iandchasse/silkscreen-audio-attachment/research/basis/README.md

# Basis notes copied from silkscreen-light-attachment (2026-11-09)

These research notes were written for the J6 light attachment. The J6 position, the case facts and the header-mating
analysis carry over unchanged; the electrical notes are about the LED pins and only partly apply. Rev 1.03 changes
(J6 pin 7 behind a 20 mA PTC) are newer than these files: see research/audio-chain.md.
