iandchasse/silkscreen-audio-attachment/pcb/docs/design_summary.md

# As-built design summary (generated by tools/report_design.py; do not edit)

Project silkscreen-audio-attachment rev A, 2026-11-09. Frames: KiCad K (x_K = X + 100, y_K = Z + 100) and enclosure E (X, Z; Y up the device). All SMD parts and the jack are on F.Cu (faces +Y, the top); the THT headers are footprints on B.Cu (bodies under the board).

Board outline bbox (K): x 97.475..162.525, y 93.975..107.025; thickness 1.000 mm; 2 copper layers.

## Parts and sourcing

- J1 Hong Cheng HC-PZ254-11.5L-1x4PZ (LCSC C27985189, JLC Extended (no Basic 2.54 mm headers are listed; checked 2026-11-09); stock 44988 on 2026-11-09), pads J6 1/2/3/4: **hand-soldered by the builder**, in bom.csv, not in jlc_bom.csv / jlc_cpl.csv.
- J2 Hong Cheng HC-PZ254-11.5L-1x1PZ (LCSC C27985186, JLC Extended (no Basic 2.54 mm headers are listed; checked 2026-11-09); stock 5114 on 2026-11-09), pads J6 9: **hand-soldered by the builder**, in bom.csv, not in jlc_bom.csv / jlc_cpl.csv.
- J3 Hong Cheng HC-PZ254-11.5L-1x1PZ (LCSC C27985186, JLC Extended (no Basic 2.54 mm headers are listed; checked 2026-11-09); stock 5114 on 2026-11-09), pads J6 12: **hand-soldered by the builder**, in bom.csv, not in jlc_bom.csv / jlc_cpl.csv.
- Header numbers: body 2.5 / post 6.0 / tail 3.0 / pin 0.64 sq. Source: LCSC/JLC product attributes 2026-11-09 (insulation height 2.5 mm, mating pin 6 mm, end pin 3 mm, square pin, brass, gold, 1x4 = C27985189, 1x1 = C27985186); total 11.5 mm from the MPN; 0.64 mm square pin assumed (not listed).
- Post tips at Y 108.10 (underside 116.60 - body 2.5 - post 6.0); J6 face Y 112.82..113.15 -> engagement 4.72..5.05 mm (limits 3.7..6.0). Tails end at Y 119.60 (2.00 above the PCB top).
- Jack SHOU HAN PJ-313D (LCSC C668608, stock 23114): origin E (2.31, 0.0), nose tip x -5.34, body y 117.6..122.6, barrel axis 2.5 above the board top; pad 1 sleeve GND, 2 ring HP_R, 3 tip HP_L.
- ICs (LCSC stock 2026-11-09): U1 TPS7A2033PDBVR C2862740 (122506), U2 PCM5102APWR C107671 (1284), U3 TPA6138A2PWR C183097 (3332), D1 BAT54SLT1G C8592 (221495).
- CPL rotation offsets (EasyEDA footprints, docs/sources/ee_*.json, tools/cpl_offsets.py): SOT-23-5 +180, TSSOP-20/-14 +270, SOT-23 +180, 0603 +0, jack +0.

## Deviations / notes

- The PJ-313D footprint carries its two Ø1.3 positioning pegs (EasyEDA HOLE records) as NPTH holes at footprint (0, -2.655) and (0, +3.358), i.e. E (-0.345, 0) and (5.668, 0): the board has 4 NPTH holes (2 x Ø4.80 screw columns + 2 x Ø1.30 jack pegs), not 2.

## Footprints

| Ref | Value | Footprint | x_K | y_K | rot | layer | X (E) | Z (E) | pads (num: net) |
|---|---|---|---|---|---|---|---|---|---|
| C1 | CL10A106KP8NNNC | C_0603_1608Metric | 161.200 | 98.500 | 90 | F.Cu | 61.200 | -1.500 | 1: /VBAT, 2: /GND |
| C2 | CL10A105KB8NNNC | C_0603_1608Metric | 155.200 | 102.600 | 0 | F.Cu | 55.200 | 2.600 | 1: /VBAT, 2: /GND |
| C3 | 0603B103K500NT | C_0603_1608Metric | 147.100 | 100.900 | 0 | F.Cu | 47.100 | 0.900 | 1: /PUMP_A, 2: /PUMP |
| C4 | CL10A105KB8NNNC | C_0603_1608Metric | 154.000 | 100.900 | 0 | F.Cu | 54.000 | 0.900 | 1: /EN_DET, 2: /GND |
| C5 | CL10A105KB8NNNC | C_0603_1608Metric | 146.100 | 102.600 | 0 | F.Cu | 46.100 | 2.600 | 1: /MUTE_RC, 2: /GND |
| C6 | CL10A105KB8NNNC | C_0603_1608Metric | 156.100 | 105.600 | 0 | F.Cu | 56.100 | 5.600 | 1: /3V3A, 2: /GND |
| C7 | CC0603KRX7R9BB104 | C_0603_1608Metric | 127.300 | 95.050 | 0 | F.Cu | 27.300 | -4.950 | 1: /3V3A, 2: /GND |
| C8 | CL10A106KP8NNNC | C_0603_1608Metric | 130.400 | 95.050 | 0 | F.Cu | 30.400 | -4.950 | 1: /3V3A, 2: /GND |
| C9 | CL10A225KO8NNNC | C_0603_1608Metric | 125.900 | 98.050 | 90 | F.Cu | 25.900 | -1.950 | 1: /DAC_CAPP, 2: /DAC_CAPM |
| C10 | CL10A225KO8NNNC | C_0603_1608Metric | 123.300 | 98.050 | 90 | F.Cu | 23.300 | -1.950 | 1: /DAC_VNEG, 2: /GND |
| C11 | CC0603KRX7R9BB104 | C_0603_1608Metric | 127.300 | 105.600 | 0 | F.Cu | 27.300 | 5.600 | 1: /3V3A, 2: /GND |
| C12 | CL10A106KP8NNNC | C_0603_1608Metric | 130.400 | 105.600 | 0 | F.Cu | 30.400 | 5.600 | 1: /3V3A, 2: /GND |
| C13 | CC0603KRX7R9BB104 | C_0603_1608Metric | 133.500 | 105.600 | 0 | F.Cu | 33.500 | 5.600 | 1: /DAC_LDOO, 2: /GND |
| C14 | CC0603KRX7R9BB104 | C_0603_1608Metric | 133.500 | 95.050 | 0 | F.Cu | 33.500 | -4.950 | 1: /3V3A, 2: /GND |
| C15 | CL10A106KP8NNNC | C_0603_1608Metric | 153.000 | 105.600 | 0 | F.Cu | 53.000 | 5.600 | 1: /3V3A, 2: /GND |
| C16 | 0603B222K500NT | C_0603_1608Metric | 136.600 | 105.600 | 0 | F.Cu | 36.600 | 5.600 | 1: /DAC_L, 2: /GND |
| C17 | 0603B222K500NT | C_0603_1608Metric | 139.700 | 105.600 | 0 | F.Cu | 39.700 | 5.600 | 1: /DAC_R, 2: /GND |
| C18 | CL10A105KB8NNNC | C_0603_1608Metric | 118.000 | 105.600 | 0 | F.Cu | 18.000 | 5.600 | 1: /3V3A, 2: /GND |
| C19 | CL10A105KB8NNNC | C_0603_1608Metric | 116.000 | 100.000 | 90 | F.Cu | 16.000 | 0.000 | 1: /AMP_CN, 2: /AMP_CP |
| C20 | CL10A105KB8NNNC | C_0603_1608Metric | 114.900 | 95.050 | 0 | F.Cu | 14.900 | -4.950 | 1: /AMP_VSS, 2: /GND |
| C21 | CL10B102KB8NNNC | C_0603_1608Metric | 110.900 | 105.600 | 0 | F.Cu | 10.900 | 5.600 | 1: /HP_L, 2: /GND |
| C22 | CL10B102KB8NNNC | C_0603_1608Metric | 113.900 | 105.600 | 0 | F.Cu | 13.900 | 5.600 | 1: /HP_R, 2: /GND |
| D1 | BAT54SLT1G | SOT-23 | 151.000 | 102.200 | 0 | F.Cu | 51.000 | 2.200 | 1: /GND, 2: /EN_DET, 3: /PUMP |
| H1 | M1 lid screw column (rev C base, left boss moved to x 12) | NPTH_4.80mm | 112.000 | 99.000 | 0 | F.Cu | 12.000 | -1.000 | npth: - |
| H2 | M2 lid screw column | NPTH_4.80mm | 138.000 | 99.000 | 0 | F.Cu | 38.000 | -1.000 | npth: - |
| J1 | HC-PZ254-11.5L-1x4PZ | J6_PLUG_1x4_P1-P4 | 148.312 | 96.190 | 0 | B.Cu | 48.312 | -3.810 | 1: /GND, 2: /I2S_BCLK, 3: /I2S_DOUT, 4: /GND |
| J2 | HC-PZ254-11.5L-1x1PZ | J6_PLUG_1x1_P9 | 149.582 | 98.730 | 0 | B.Cu | 49.582 | -1.270 | 9: /I2S_WS |
| J3 | HC-PZ254-11.5L-1x1PZ | J6_PLUG_1x1_P12 | 157.202 | 98.730 | 0 | B.Cu | 57.202 | -1.270 | 12: /VBAT |
| J4 | PJ-313D | JACK_3.5mm_SHOUHAN_PJ-313D | 102.310 | 100.000 | 90 | F.Cu | 2.310 | 0.000 | npth: -, npth: -, 1: /GND, 1: /GND, 2: /HP_R, 2: /HP_R, 3: /HP_L, 3: /HP_L |
| R1 | 0603WAF1001T5E | R_0603_1608Metric | 144.000 | 100.900 | 0 | F.Cu | 44.000 | 0.900 | 1: /I2S_WS, 2: /PUMP_A |
| R2 | 0603WAF1004T5E | R_0603_1608Metric | 157.100 | 100.700 | 0 | F.Cu | 57.100 | 0.700 | 1: /EN_DET, 2: /GND |
| R3 | 0603WAF1003T5E | R_0603_1608Metric | 143.000 | 102.600 | 0 | F.Cu | 43.000 | 2.600 | 1: /EN_DET, 2: /MUTE_RC |
| R4 | 0603WAF1002T5E | R_0603_1608Metric | 118.000 | 95.050 | 0 | F.Cu | 18.000 | -4.950 | 1: /MUTE_RC, 2: /AMP_MUTE |
| R5 | 0603WAF1003T5E | R_0603_1608Metric | 142.800 | 105.600 | 0 | F.Cu | 42.800 | 5.600 | 1: /I2S_BCLK, 2: /GND |
| R6 | 0603WAF1003T5E | R_0603_1608Metric | 145.900 | 105.600 | 0 | F.Cu | 45.900 | 5.600 | 1: /I2S_DOUT, 2: /GND |
| R7 | 0603WAF1002T5E | R_0603_1608Metric | 149.000 | 105.600 | 0 | F.Cu | 49.000 | 5.600 | 1: /I2S_WS, 2: /GND |
| R8 | 0603WAF4700T5E | R_0603_1608Metric | 125.900 | 101.950 | 90 | F.Cu | 25.900 | 1.950 | 1: /DAC_OUTL, 2: /DAC_L |
| R9 | 0603WAF4700T5E | R_0603_1608Metric | 123.300 | 101.950 | 90 | F.Cu | 23.300 | 1.950 | 1: /DAC_OUTR, 2: /DAC_R |
| R10 | 0603WAF1002T5E | R_0603_1608Metric | 124.200 | 105.600 | 0 | F.Cu | 24.200 | 5.600 | 1: /DAC_L, 2: /AMP_INL |
| R11 | 0603WAF1002T5E | R_0603_1608Metric | 121.100 | 105.600 | 0 | F.Cu | 21.100 | 5.600 | 1: /AMP_INL, 2: /AMP_OUTL |
| R12 | 0603WAF1002T5E | R_0603_1608Metric | 124.200 | 95.050 | 0 | F.Cu | 24.200 | -4.950 | 1: /DAC_R, 2: /AMP_INR |
| R13 | 0603WAF1002T5E | R_0603_1608Metric | 121.100 | 95.050 | 0 | F.Cu | 21.100 | -4.950 | 1: /AMP_INR, 2: /AMP_OUTR |
| R14 | 0603WAF100JT5E | R_0603_1608Metric | 110.900 | 103.100 | 0 | F.Cu | 10.900 | 3.100 | 1: /AMP_OUTL, 2: /HP_L |
| R15 | 0603WAF100JT5E | R_0603_1608Metric | 113.900 | 103.100 | 0 | F.Cu | 13.900 | 3.100 | 1: /AMP_OUTR, 2: /HP_R |
| U1 | TPS7A2033PDBVR | SOT-23-5 | 160.200 | 103.300 | 0 | F.Cu | 60.200 | 3.300 | 1: /VBAT, 2: /GND, 3: /EN_DET, 4: unconnected-(U1-NC-Pad4), 5: /3V3A |
| U2 | PCM5102APWR | TSSOP-20_4.4x6.5mm_P0.65mm | 130.900 | 100.000 | 0 | F.Cu | 30.900 | 0.000 | 1: /3V3A, 2: /DAC_CAPP, 3: /GND, 4: /DAC_CAPM, 5: /DAC_VNEG, 6: /DAC_OUTL, 7: /DAC_OUTR, 8: /3V3A, 9: /GND, 10: /GND, 11: /GND, 12: /GND, 13: /I2S_BCLK, 14: /I2S_DOUT, 15: /I2S_WS, 16: /GND, 17: /3V3A, 18: /DAC_LDOO, 19: /GND, 20: /3V3A |
| U3 | TPA6138A2PWR | TSSOP-14_4.4x5mm_P0.65mm | 119.500 | 100.000 | -90 | F.Cu | 19.500 | 0.000 | 1: /GND, 2: /AMP_INR, 3: /AMP_OUTR, 4: /GND, 5: /AMP_MUTE, 6: /AMP_VSS, 7: /AMP_CN, 8: /AMP_CP, 9: /3V3A, 10: /GND, 11: unconnected-(U3-UVP-Pad11), 12: /AMP_OUTL, 13: /AMP_INL, 14: /GND |

## Copper by net

| Net | F.Cu mm | B.Cu mm | vias |
|---|---|---|---|
| /3V3A | 64.2 | 6.8 | 2 |
| /AMP_CN | 0.7 | 3.1 | 2 |
| /AMP_CP | 1.3 | 1.7 | 2 |
| /AMP_INL | 3.3 | 3.3 | 2 |
| /AMP_INR | 2.5 | 3.3 | 2 |
| /AMP_MUTE | 1.6 | 0.0 | 0 |
| /AMP_OUTL | 6.5 | 9.5 | 2 |
| /AMP_OUTR | 16.4 | 0.0 | 0 |
| /AMP_VSS | 5.5 | 0.0 | 0 |
| /DAC_CAPM | 1.7 | 0.0 | 0 |
| /DAC_CAPP | 4.8 | 0.0 | 0 |
| /DAC_L | 15.9 | 0.0 | 0 |
| /DAC_LDOO | 7.3 | 0.0 | 0 |
| /DAC_OUTL | 3.9 | 3.6 | 2 |
| /DAC_OUTR | 2.2 | 2.0 | 2 |
| /DAC_R | 8.1 | 13.6 | 2 |
| /DAC_VNEG | 1.8 | 3.5 | 2 |
| /EN_DET | 19.4 | 5.3 | 2 |
| /GND | 11.6 | 0.0 | 95 |
| /HP_L | 10.8 | 0.0 | 0 |
| /HP_R | 17.3 | 0.0 | 0 |
| /I2S_BCLK | 7.7 | 10.7 | 2 |
| /I2S_DOUT | 2.3 | 21.2 | 2 |
| /I2S_WS | 27.3 | 0.0 | 0 |
| /MUTE_RC | 1.1 | 40.4 | 3 |
| /PUMP | 2.5 | 1.2 | 2 |
| /PUMP_A | 0.7 | 0.0 | 0 |
| /VBAT | 10.1 | 0.0 | 0 |

## Handedness / placement gate (tools/check_handedness.py)

- PASS STEP->E rotation determinant 1 (proper rotation, not a mirror)
- PASS F.Cu face seen from +Y: right = +X, down = (0, 0, 1) = +Z, so x_K = X + 100, y_K = Z + 100 is unmirrored
- PASS exactly 6 plated through-holes, all on J1/J2/J3 (found 6)
- PASS J3 '12' at E (57.202, -1.270) vs J6-12 (57.202, -1.270): 0.0000 <= 0.02
- PASS J3 '12' via the STEP chain: E (57.202, Y 116.60, -1.270) agrees
- PASS J3 '12' net VBAT == VBAT
- PASS J2 '9' at E (49.582, -1.270) vs J6-9 (49.582, -1.270): 0.0000 <= 0.02
- PASS J2 '9' via the STEP chain: E (49.582, Y 116.60, -1.270) agrees
- PASS J2 '9' net I2S_WS == I2S_WS
- PASS J1 '1' at E (44.502, -3.810) vs J6-1 (44.502, -3.810): 0.0000 <= 0.02
- PASS J1 '1' via the STEP chain: E (44.502, Y 116.60, -3.810) agrees
- PASS J1 '1' net GND == GND
- PASS J1 '2' at E (47.042, -3.810) vs J6-2 (47.042, -3.810): 0.0000 <= 0.02
- PASS J1 '2' via the STEP chain: E (47.042, Y 116.60, -3.810) agrees
- PASS J1 '2' net I2S_BCLK == I2S_BCLK
- PASS J1 '3' at E (49.582, -3.810) vs J6-3 (49.582, -3.810): 0.0000 <= 0.02
- PASS J1 '3' via the STEP chain: E (49.582, Y 116.60, -3.810) agrees
- PASS J1 '3' net I2S_DOUT == I2S_DOUT
- PASS J1 '4' at E (52.122, -3.810) vs J6-4 (52.122, -3.810): 0.0000 <= 0.02
- PASS J1 '4' via the STEP chain: E (52.122, Y 116.60, -3.810) agrees
- PASS J1 '4' net GND == GND
- PASS J1 footprint on B.Cu (body under the board)
- PASS J2 footprint on B.Cu (body under the board)
- PASS J3 footprint on B.Cu (body under the board)
- PASS J4 on F.Cu (top side)
- PASS J4 origin at E (2.310, 0.000)
- PASS J4 nose tip at x -5.340 (spec -5.34), rotation 90 (nose toward -X)
- PASS J4 has 6 SMD pads (found 6)
- PASS J4 pad 1 at E (-1.045, 3.600) (want x -1.045, z +-3.60)
- PASS J4 pad 1 net GND == GND
- PASS J4 pad 1 at E (-1.045, -3.600) (want x -1.045, z +-3.60)
- PASS J4 pad 1 net GND == GND
- PASS J4 pad 2 at E (2.165, 3.600) (want x 2.165, z +-3.60)
- PASS J4 pad 2 net HP_R == HP_R
- PASS J4 pad 2 at E (2.165, -3.600) (want x 2.165, z +-3.60)
- PASS J4 pad 2 net HP_R == HP_R
- PASS J4 pad 3 at E (5.666, 3.600) (want x 5.666, z +-3.60)
- PASS J4 pad 3 net HP_L == HP_L
- PASS J4 pad 3 at E (5.666, -3.600) (want x 5.666, z +-3.60)
- PASS J4 pad 3 net HP_L == HP_L
- PASS J6-5 (LED_SW up to 25.5 V) at E (54.662, -3.81): nearest pad 1.690, via 1.034, hole 1.184 (>= 1.0)
- PASS J6-6 (W-) at E (57.202, -3.81): nearest pad 1.690, via 1.217, hole 1.367 (>= 1.0)
- PASS J6-7 (J6_3V3) at E (44.502, -1.27): nearest pad 1.690, via 1.488, hole 1.638 (>= 1.0)
- PASS J6-8 (SDA) at E (47.042, -1.27): nearest pad 1.690, via 2.190, hole 2.030 (>= 1.0)
- PASS J6-10 (SCL) at E (52.122, -1.27): nearest pad 1.690, via 1.036, hole 1.186 (>= 1.0)
- PASS J6-11 (C-) at E (54.662, -1.27): nearest pad 1.690, via 1.105, hole 1.255 (>= 1.0)
- PASS 4 NPTH holes (params: 4 = 2 screw columns + 2 jack pegs)
- PASS NPTH M1 dia 4.8 at E (12.000, -1.000)
- PASS NPTH M2 dia 4.8 at E (38.000, -1.000)
- PASS NPTH peg dia 1.3 at E (-0.345, 0.000)
- PASS NPTH peg dia 1.3 at E (5.668, 0.000)
- PASS copper (pads/tracks/vias) to the screw-column hole edges min 0.549 >= 0.4
- PASS tracks to the screw-column hole edges min 0.549 >= 0.5
- PASS R12 on F.Cu
- PASS R12 pads E x 22.97..25.42 z -5.42..-4.47, h 0.55: inside the region, clear of the columns and header pads
- PASS C4 on F.Cu
- PASS C4 pads E x 52.78..55.22 z 0.42..1.38, h 0.95: inside the region, clear of the columns and header pads
- PASS C10 on F.Cu
- PASS C10 pads E x 22.83..23.78 z -3.17..-0.72, h 0.95: inside the region, clear of the columns and header pads
- PASS C9 on F.Cu
- PASS C9 pads E x 25.42..26.38 z -3.17..-0.72, h 0.95: inside the region, clear of the columns and header pads
- PASS C20 on F.Cu
- PASS C20 pads E x 13.67..16.12 z -5.42..-4.47, h 0.95: inside the region, clear of the columns and header pads
- PASS C16 on F.Cu
- PASS C16 pads E x 35.38..37.82 z 5.12..6.08, h 0.95: inside the region, clear of the columns and header pads
- PASS U3 on F.Cu
- PASS U3 pads E x 17.35..21.65 z -3.60..3.60, h 1.2: inside the region, clear of the columns and header pads
- PASS R10 on F.Cu
- PASS R10 pads E x 22.97..25.42 z 5.12..6.08, h 0.55: inside the region, clear of the columns and header pads
- PASS R7 on F.Cu
- PASS R7 pads E x 47.78..50.22 z 5.12..6.08, h 0.55: inside the region, clear of the columns and header pads
- PASS R4 on F.Cu
- PASS R4 pads E x 16.78..19.22 z -5.42..-4.47, h 0.55: inside the region, clear of the columns and header pads
- PASS R9 on F.Cu
- PASS R9 pads E x 22.83..23.78 z 0.72..3.17, h 0.55: inside the region, clear of the columns and header pads
- PASS C8 on F.Cu
- PASS C8 pads E x 29.18..31.62 z -5.42..-4.47, h 0.95: inside the region, clear of the columns and header pads
- PASS C13 on F.Cu
- PASS C13 pads E x 32.28..34.72 z 5.12..6.08, h 0.95: inside the region, clear of the columns and header pads
- PASS R11 on F.Cu
- PASS R11 pads E x 19.88..22.33 z 5.12..6.08, h 0.55: inside the region, clear of the columns and header pads
- PASS C18 on F.Cu
- PASS C18 pads E x 16.78..19.22 z 5.12..6.08, h 0.95: inside the region, clear of the columns and header pads
- PASS C14 on F.Cu
- PASS C14 pads E x 32.28..34.72 z -5.42..-4.47, h 0.95: inside the region, clear of the columns and header pads
- PASS C11 on F.Cu
- PASS C11 pads E x 26.08..28.53 z 5.12..6.08, h 0.95: inside the region, clear of the columns and header pads
- PASS C3 on F.Cu
- PASS C3 pads E x 45.88..48.32 z 0.42..1.38, h 0.95: inside the region, clear of the columns and header pads
- PASS D1 on F.Cu
- PASS D1 pads E x 49.32..52.68 z 0.95..3.45, h 1.15: inside the region, clear of the columns and header pads
- PASS C7 on F.Cu
- PASS C7 pads E x 26.08..28.53 z -5.42..-4.47, h 0.95: inside the region, clear of the columns and header pads
- PASS R14 on F.Cu
- PASS R14 pads E x 9.67..12.12 z 2.62..3.58, h 0.55: inside the region, clear of the columns and header pads
- PASS R5 on F.Cu
- PASS R5 pads E x 41.57..44.03 z 5.12..6.08, h 0.55: inside the region, clear of the columns and header pads
- PASS C12 on F.Cu
- PASS C12 pads E x 29.18..31.62 z 5.12..6.08, h 0.95: inside the region, clear of the columns and header pads
- PASS J4 on F.Cu
- PASS R8 on F.Cu
- PASS R8 pads E x 25.42..26.38 z 0.72..3.17, h 0.55: inside the region, clear of the columns and header pads
- PASS C17 on F.Cu
- PASS C17 pads E x 38.47..40.93 z 5.12..6.08, h 0.95: inside the region, clear of the columns and header pads
- PASS R6 on F.Cu
- PASS R6 pads E x 44.68..47.12 z 5.12..6.08, h 0.55: inside the region, clear of the columns and header pads
- PASS R3 on F.Cu
- PASS R3 pads E x 41.78..44.22 z 2.12..3.08, h 0.55: inside the region, clear of the columns and header pads
- PASS R13 on F.Cu
- PASS R13 pads E x 19.88..22.33 z -5.42..-4.47, h 0.55: inside the region, clear of the columns and header pads
- PASS C19 on F.Cu
- PASS C19 pads E x 15.53..16.47 z -1.22..1.22, h 0.95: inside the region, clear of the columns and header pads
- PASS C15 on F.Cu
- PASS C15 pads E x 51.78..54.22 z 5.12..6.08, h 0.95: inside the region, clear of the columns and header pads
- PASS C6 on F.Cu
- PASS C6 pads E x 54.88..57.32 z 5.12..6.08, h 0.95: inside the region, clear of the columns and header pads
- PASS C21 on F.Cu
- PASS C21 pads E x 9.67..12.12 z 5.12..6.08, h 0.95: inside the region, clear of the columns and header pads
- PASS R1 on F.Cu
- PASS R1 pads E x 42.78..45.22 z 0.42..1.38, h 0.55: inside the region, clear of the columns and header pads
- PASS U2 on F.Cu
- PASS U2 pads E x 27.30..34.50 z -3.12..3.12, h 1.2: inside the region, clear of the columns and header pads
- PASS U1 on F.Cu
- PASS U1 pads E x 58.40..62.00 z 2.05..4.55, h 1.25: inside the region, clear of the columns and header pads
- PASS C1 on F.Cu
- PASS C1 pads E x 60.72..61.68 z -2.72..-0.28, h 0.95: inside the region, clear of the columns and header pads
- PASS R2 on F.Cu
- PASS R2 pads E x 55.88..58.32 z 0.22..1.17, h 0.55: inside the region, clear of the columns and header pads
- PASS C2 on F.Cu
- PASS C2 pads E x 53.97..56.43 z 2.12..3.08, h 0.95: inside the region, clear of the columns and header pads
- PASS R15 on F.Cu
- PASS R15 pads E x 12.67..15.12 z 2.62..3.58, h 0.55: inside the region, clear of the columns and header pads
- PASS C22 on F.Cu
- PASS C22 pads E x 12.67..15.12 z 5.12..6.08, h 0.95: inside the region, clear of the columns and header pads
- PASS C5 on F.Cu
- PASS C5 pads E x 44.88..47.32 z 2.12..3.08, h 0.95: inside the region, clear of the columns and header pads
- PASS NPTH J4@E(-0.34,0.00): web to board edge 1.505 >= 0.5
- PASS NPTH H1@E(12.00,-1.00): web to board edge 2.600 >= 0.5
- PASS NPTH H2@E(38.00,-1.00): web to board edge 2.600 >= 0.5
- PASS NPTH J4@E(5.67,0.00): web to board edge 5.350 >= 0.5
- INFO outline 8 Edge.Cuts primitives; min NPTH web 1.505
- PASS silk: 103 strokes, min width 0.150 >= 0.15
- PASS silk: 10 visible texts, min height 1.000, min stroke 0.150
