iandchasse/silkscreen-audio-attachment/housing/out/render/exploded_iso.png

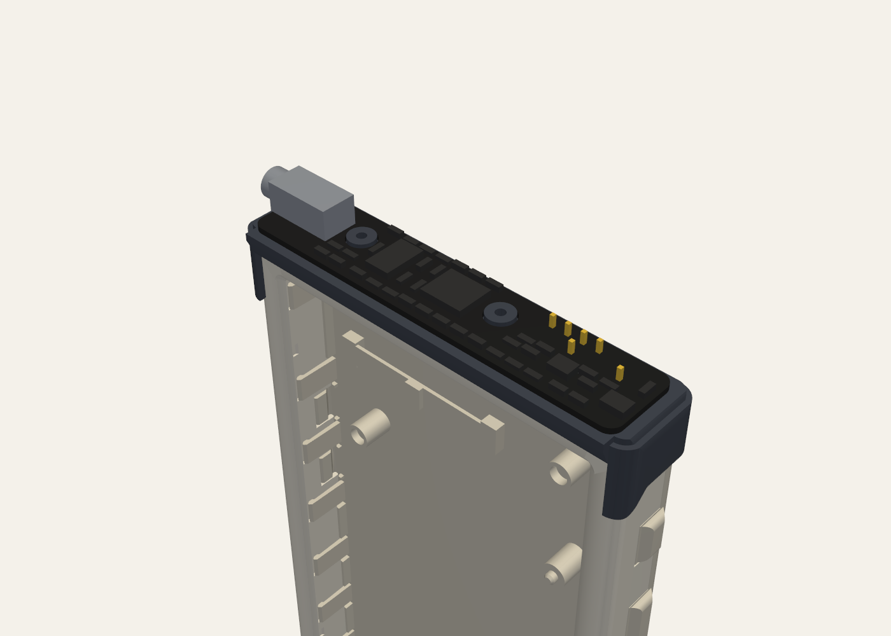
housing/out/render/exploded_iso.png
