iandchasse/silkscreen-audio-attachment/housing/out/render/front.png

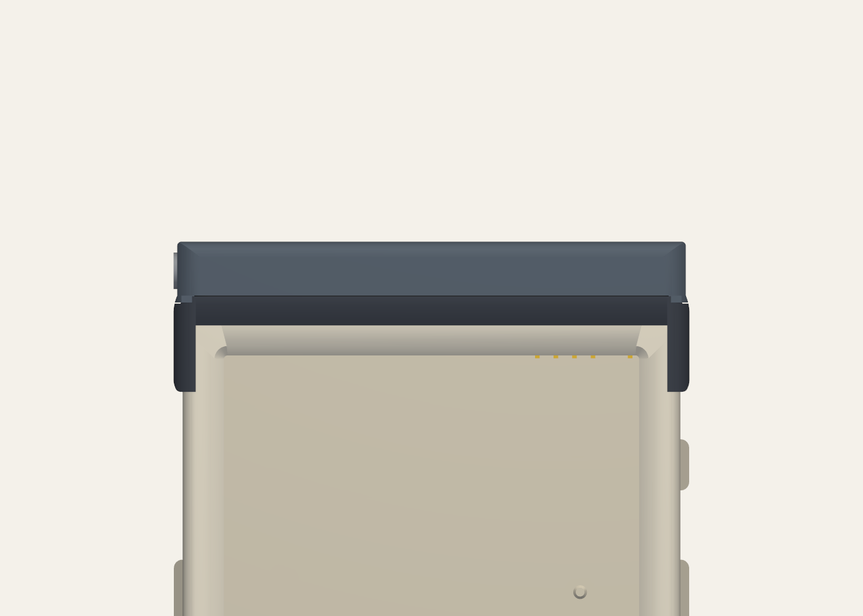
housing/out/render/front.png
