iandchasse/silkscreen-audio-attachment/housing/out/render/left_end_iso.png

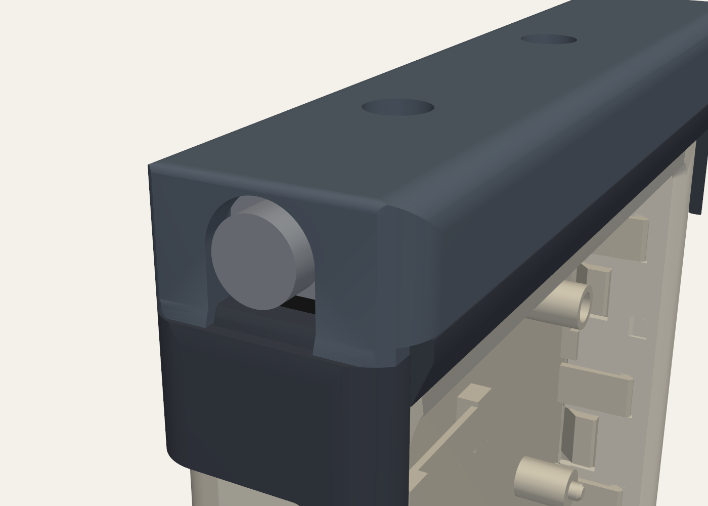
housing/out/render/left_end_iso.png
