iandchasse/silkscreen-audio-attachment/housing/out/render/left_end_jack_opening.png

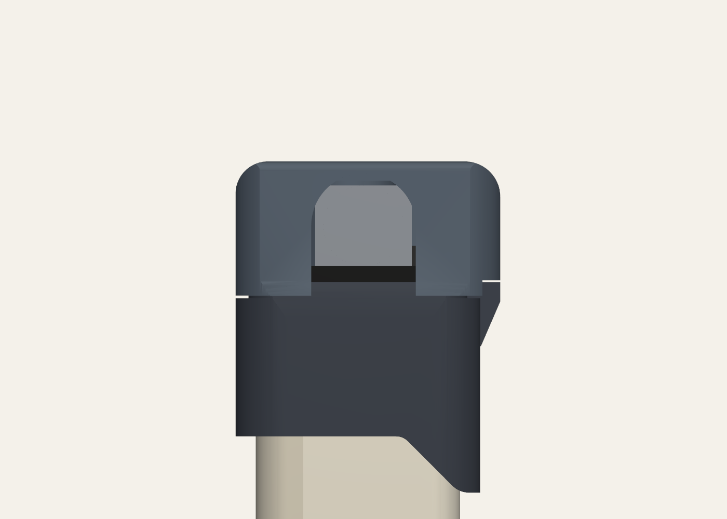
housing/out/render/left_end_jack_opening.png
