iandchasse/silkscreen-audio-attachment/housing/out/render/section_boss_x12.png

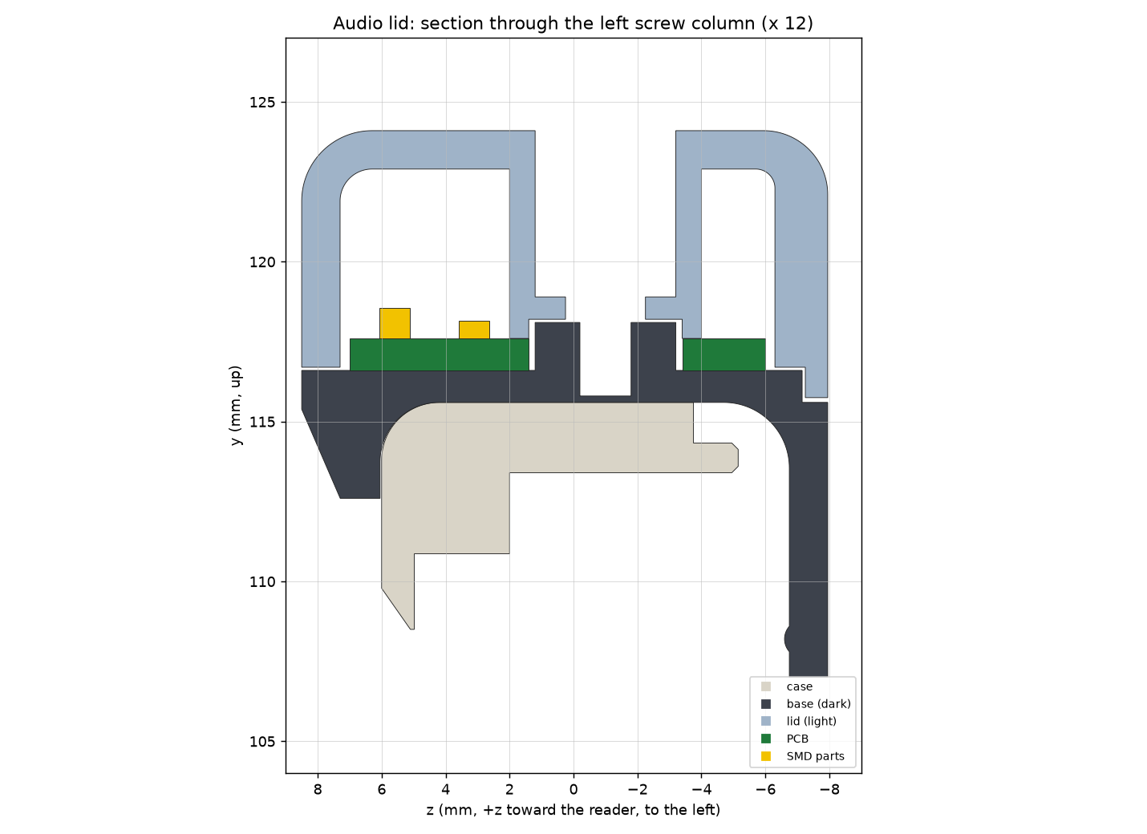
housing/out/render/section_boss_x12.png
