iandchasse/silkscreen-audio-attachment/housing/out/render/section_jack_axis_z0.png

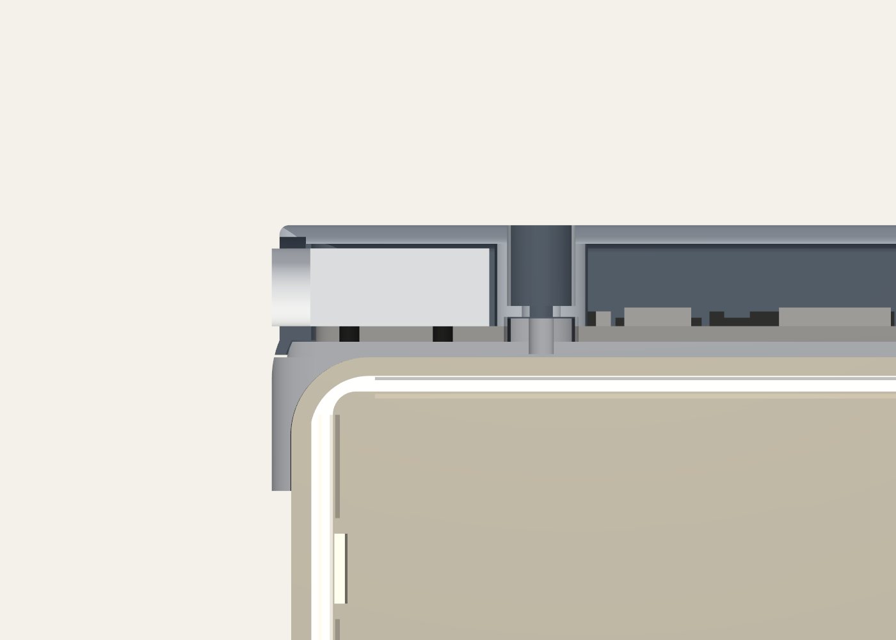
housing/out/render/section_jack_axis_z0.png
