iandchasse/silkscreen-audio-attachment/housing/out/render/section_jack_x2.3.png

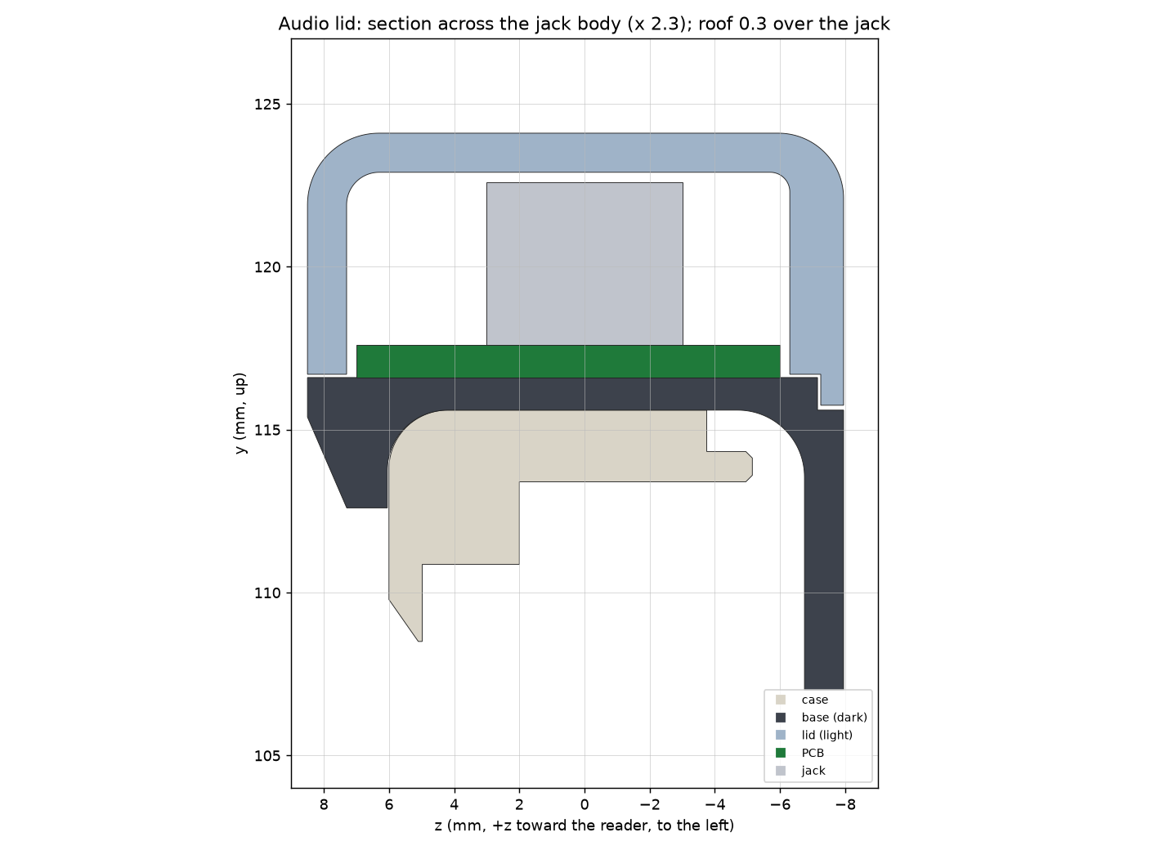
housing/out/render/section_jack_x2.3.png
