iandchasse/silkscreen-audio-attachment/housing/out/render/section_plug_opening_x-4.png

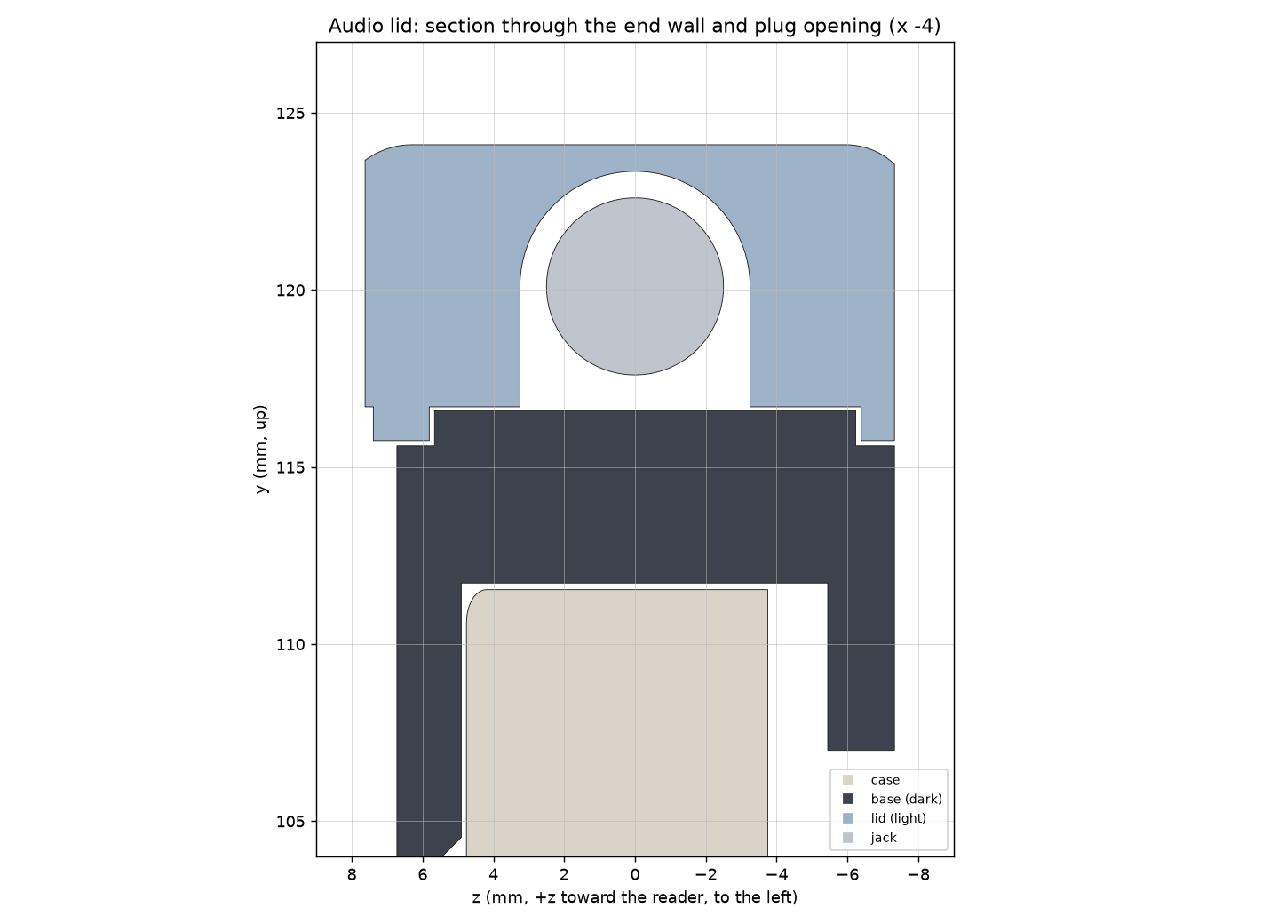
housing/out/render/section_plug_opening_x-4.png
