iandchasse/silkscreen-audio-attachment/pcb/docs/images/render_bottom.png

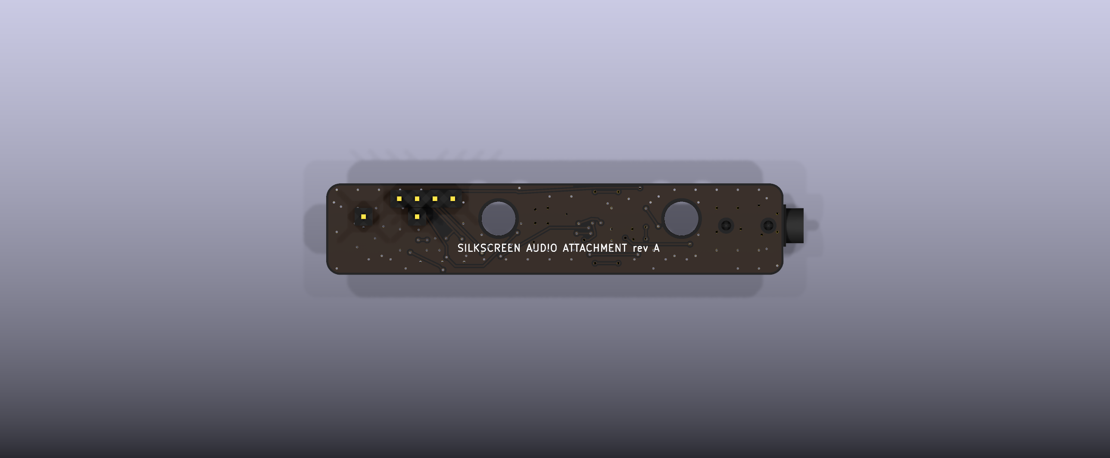
pcb/docs/images/render_bottom.png
