iandchasse/silkscreen-audio-attachment/pcb/production/bom.csv

Qty | Refs | Value | Manufacturer | MPN | DigiKey | LCSC | JLC type | Footprint | Assembly | Description
4 | C1,C8,C12,C15 | CL10A106KP8NNNC | Samsung Electro-Mechanics | CL10A106KP8NNNC | search DigiKey for CL10A106KP8NNNC (part number not verified) | C19702 | JLC Basic | C_0603_1608Metric | JLC SMT (top side) | 10 uF 10 V X5R 0603
7 | C2,C4,C5,C6,C18,C19,C20 | CL10A105KB8NNNC | Samsung Electro-Mechanics | CL10A105KB8NNNC | search DigiKey for CL10A105KB8NNNC (part number not verified) | C15849 | JLC Basic | C_0603_1608Metric | JLC SMT (top side) | 1 uF 50 V X5R 0603
1 | C3 | 0603B103K500NT | Fenghua (FH) | 0603B103K500NT | search DigiKey for 0603B103K500NT (part number not verified) | C57112 | JLC Basic | C_0603_1608Metric | JLC SMT (top side) | 10 nF 50 V X7R 0603
4 | C7,C11,C13,C14 | CC0603KRX7R9BB104 | Yageo | CC0603KRX7R9BB104 | search DigiKey for CC0603KRX7R9BB104 (part number not verified) | C14663 | JLC Basic | C_0603_1608Metric | JLC SMT (top side) | 100 nF 50 V X7R 0603
2 | C9,C10 | CL10A225KO8NNNC | Samsung Electro-Mechanics | CL10A225KO8NNNC | search DigiKey for CL10A225KO8NNNC (part number not verified) | C23630 | JLC Basic | C_0603_1608Metric | JLC SMT (top side) | 2.2 uF 16 V X5R 0603
2 | C16,C17 | 0603B222K500NT | Fenghua (FH) | 0603B222K500NT | search DigiKey for 0603B222K500NT (part number not verified) | C1604 | JLC Basic | C_0603_1608Metric | JLC SMT (top side) | 2.2 nF 50 V X7R 0603
2 | C21,C22 | CL10B102KB8NNNC | Samsung Electro-Mechanics | CL10B102KB8NNNC | search DigiKey for CL10B102KB8NNNC (part number not verified) | C1588 | JLC Basic | C_0603_1608Metric | JLC SMT (top side) | 1 nF 50 V X7R 0603
1 | D1 | BAT54SLT1G | onsemi | BAT54SLT1G | BAT54SLT1GOSCT-ND | C8592 | JLC Extended | SOT-23 | JLC SMT (top side) | Dual Schottky diode, series pair, SOT-23. JLC/LCSC part: Jiangsu Changjing BAT54S (C8592)
1 | J1 | HC-PZ254-11.5L-1x4PZ | Hong Cheng | HC-PZ254-11.5L-1x4PZ | n/a - Hong Cheng is LCSC-only; DigiKey equivalent: Harwin M20-999 series 1x4 cut from a longer strip (6.1 mm post, 3 mm tail), part number not verified | C27985189 | JLC Extended | J6_PLUG_1x4_P1-P4 | THT: JLC hand-solders it, or untick it at JLC and solder it yourself | 1x4 2.54 mm straight male pin header, body 2.5, mating post 6.0, tail 3.0, 0.64 sq; mounted from the underside, soldered by the builder on the top side; pins = J6 1/2/3/4
1 | J2 | HC-PZ254-11.5L-1x1PZ | Hong Cheng | HC-PZ254-11.5L-1x1PZ | 1 pin cut from a Harwin M20-999 series strip (6.1 mm post, 3 mm tail), part number not verified | C27985186 | JLC Extended | J6_PLUG_1x1_P9 | THT: JLC hand-solders it, or untick it at JLC and solder it yourself | 1x1 2.54 mm straight male pin header, body 2.5, mating post 6.0, tail 3.0, 0.64 sq; mounted from the underside, soldered by the builder on the top side; pins = J6 9
1 | J3 | HC-PZ254-11.5L-1x1PZ | Hong Cheng | HC-PZ254-11.5L-1x1PZ | 1 pin cut from a Harwin M20-999 series strip (6.1 mm post, 3 mm tail), part number not verified | C27985186 | JLC Extended | J6_PLUG_1x1_P12 | THT: JLC hand-solders it, or untick it at JLC and solder it yourself | 1x1 2.54 mm straight male pin header, body 2.5, mating post 6.0, tail 3.0, 0.64 sq; mounted from the underside, soldered by the builder on the top side; pins = J6 12
1 | J4 | PJ-313D | SHOU HAN | PJ-313D | none (LCSC only); DigiKey alternative with a different land: CUI SJ-3524-SMT-TR | C668608 | JLC Extended | JACK_3.5mm_SHOUHAN_PJ-313D | JLC SMT (top side) | 3.5 mm stereo headphone jack, SMD, 14 x 6 x 5 mm; pad 1 sleeve (GND), 2 ring (HP_R), 3 tip (HP_L); both tabs of a contact share the pad number
1 | R1 | 0603WAF1001T5E | UNI-ROYAL | 0603WAF1001T5E | search DigiKey for 0603WAF1001T5E (part number not verified) | C21190 | JLC Basic | R_0603_1608Metric | JLC SMT (top side) | 1 kOhm 1 % 0603
1 | R2 | 0603WAF1004T5E | UNI-ROYAL | 0603WAF1004T5E | search DigiKey for 0603WAF1004T5E (part number not verified) | C22935 | JLC Basic | R_0603_1608Metric | JLC SMT (top side) | 1 MOhm 1 % 0603
3 | R3,R5,R6 | 0603WAF1003T5E | UNI-ROYAL | 0603WAF1003T5E | search DigiKey for 0603WAF1003T5E (part number not verified) | C25803 | JLC Basic | R_0603_1608Metric | JLC SMT (top side) | 100 kOhm 1 % 0603
6 | R4,R7,R10,R11,R12,R13 | 0603WAF1002T5E | UNI-ROYAL | 0603WAF1002T5E | search DigiKey for 0603WAF1002T5E (part number not verified) | C25804 | JLC Basic | R_0603_1608Metric | JLC SMT (top side) | 10 kOhm 1 % 0603
2 | R8,R9 | 0603WAF4700T5E | UNI-ROYAL | 0603WAF4700T5E | search DigiKey for 0603WAF4700T5E (part number not verified) | C23179 | JLC Basic | R_0603_1608Metric | JLC SMT (top side) | 470 Ohm 1 % 0603
2 | R14,R15 | 0603WAF100JT5E | UNI-ROYAL | 0603WAF100JT5E | search DigiKey for 0603WAF100JT5E (part number not verified) | C22859 | JLC Basic | R_0603_1608Metric | JLC SMT (top side) | 10 Ohm 0603
1 | U1 | TPS7A2033PDBVR | Texas Instruments | TPS7A2033PDBVR | 296-TPS7A2033PDBVRCT-ND | C2862740 | JLC Extended | SOT-23-5 | JLC SMT (top side) | 3.3 V 300 mA ultra-low-noise LDO with enable, SOT-23-5
1 | U2 | PCM5102APWR | Texas Instruments | PCM5102APWR | 296-36707-1-ND | C107671 | JLC Extended | TSSOP-20_4.4x6.5mm_P0.65mm | JLC SMT (top side) | 112 dB stereo audio DAC, 32-bit 384 kHz I2S, BCK PLL (no MCLK), TSSOP-20
1 | U3 | TPA6138A2PWR | Texas Instruments | TPA6138A2PWR | 296-28248-1-ND | C183097 | JLC Extended | TSSOP-14_4.4x5mm_P0.65mm | JLC SMT (top side) | DirectPath ground-centred stereo headphone amplifier, TSSOP-14
