iandchasse/silkscreen-audio-attachment/housing/out/print/base.step

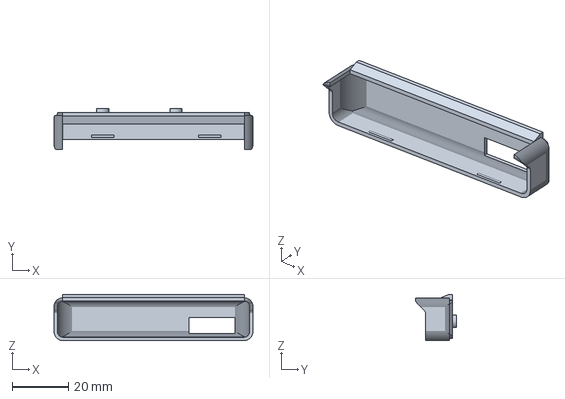
[picture p11: CAD file, 2026-11-09]
housing/out/print/base.step
70.7 x 14.6 x 16.4 mm
