iandchasse/silkscreen-audio-attachment/pcb/production/3d/silkscreen-audio-attachment_pcba_E.step

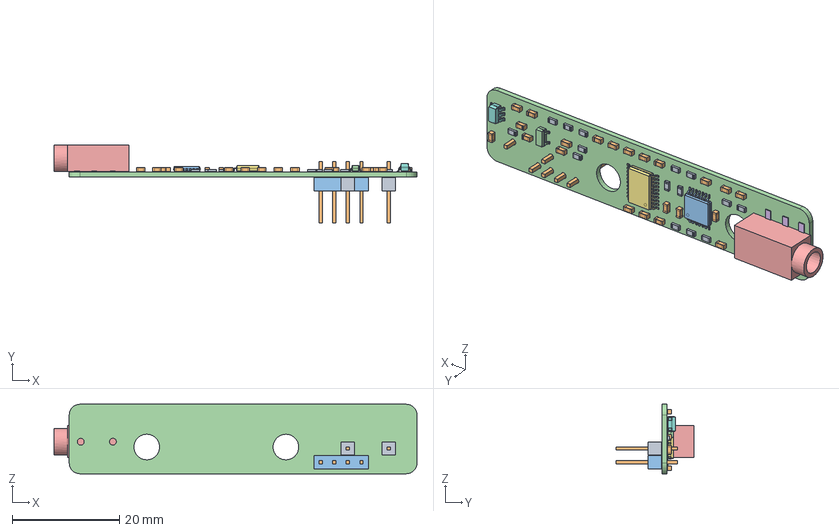
[picture p12: CAD file, 2026-11-09]
pcb/production/3d/silkscreen-audio-attachment_pcba_E.step
67.8 x 14.6 x 13.0 mm
