iandchasse/silkscreen-audio-attachment/housing/out/print/plate.3mf

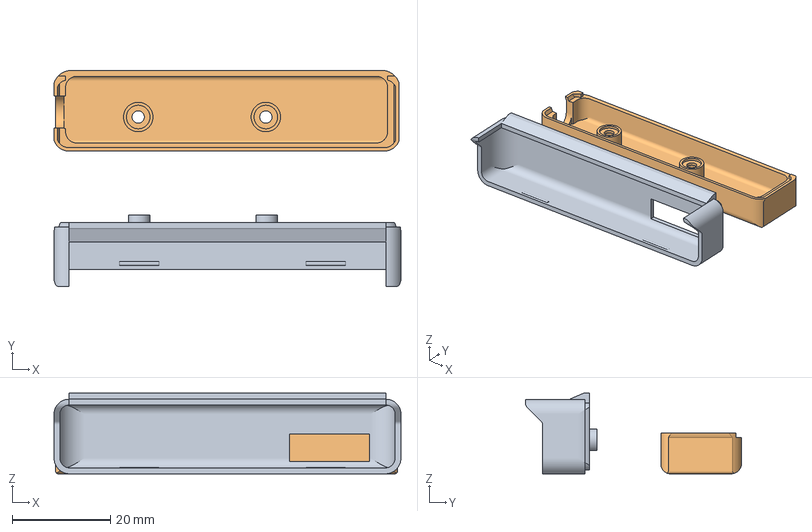
[picture p13: CAD file, 2026-11-09]
housing/out/print/plate.3mf
70.7 x 44.0 x 16.4 mm
geometry_0
geometry_1
