iandchasse/silkscreen-audio-attachment/housing/out/print/lid.step

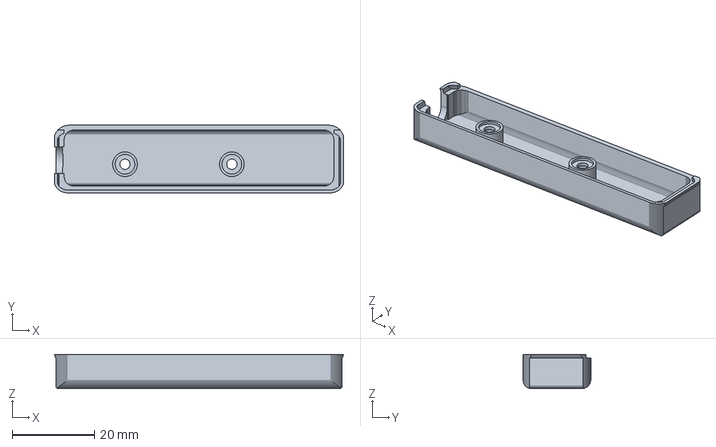
[picture p14: CAD file, 2026-11-09]
housing/out/print/lid.step
70.3 x 16.4 x 8.35 mm
