iandchasse/silkscreen-audio-attachment/(list of files, cad)

Other CAD files:
pcb/production/3d/silkscreen-audio-attachment.step
housing/out/print/base.stl
housing/out/print/lid.stl
pcb/production/3d/silkscreen-audio-attachment_pcba_E.stl
