iandchasse/silkscreen-audio-attachment/pcb/docs/silkscreen-audio-attachment_schematic.pdf

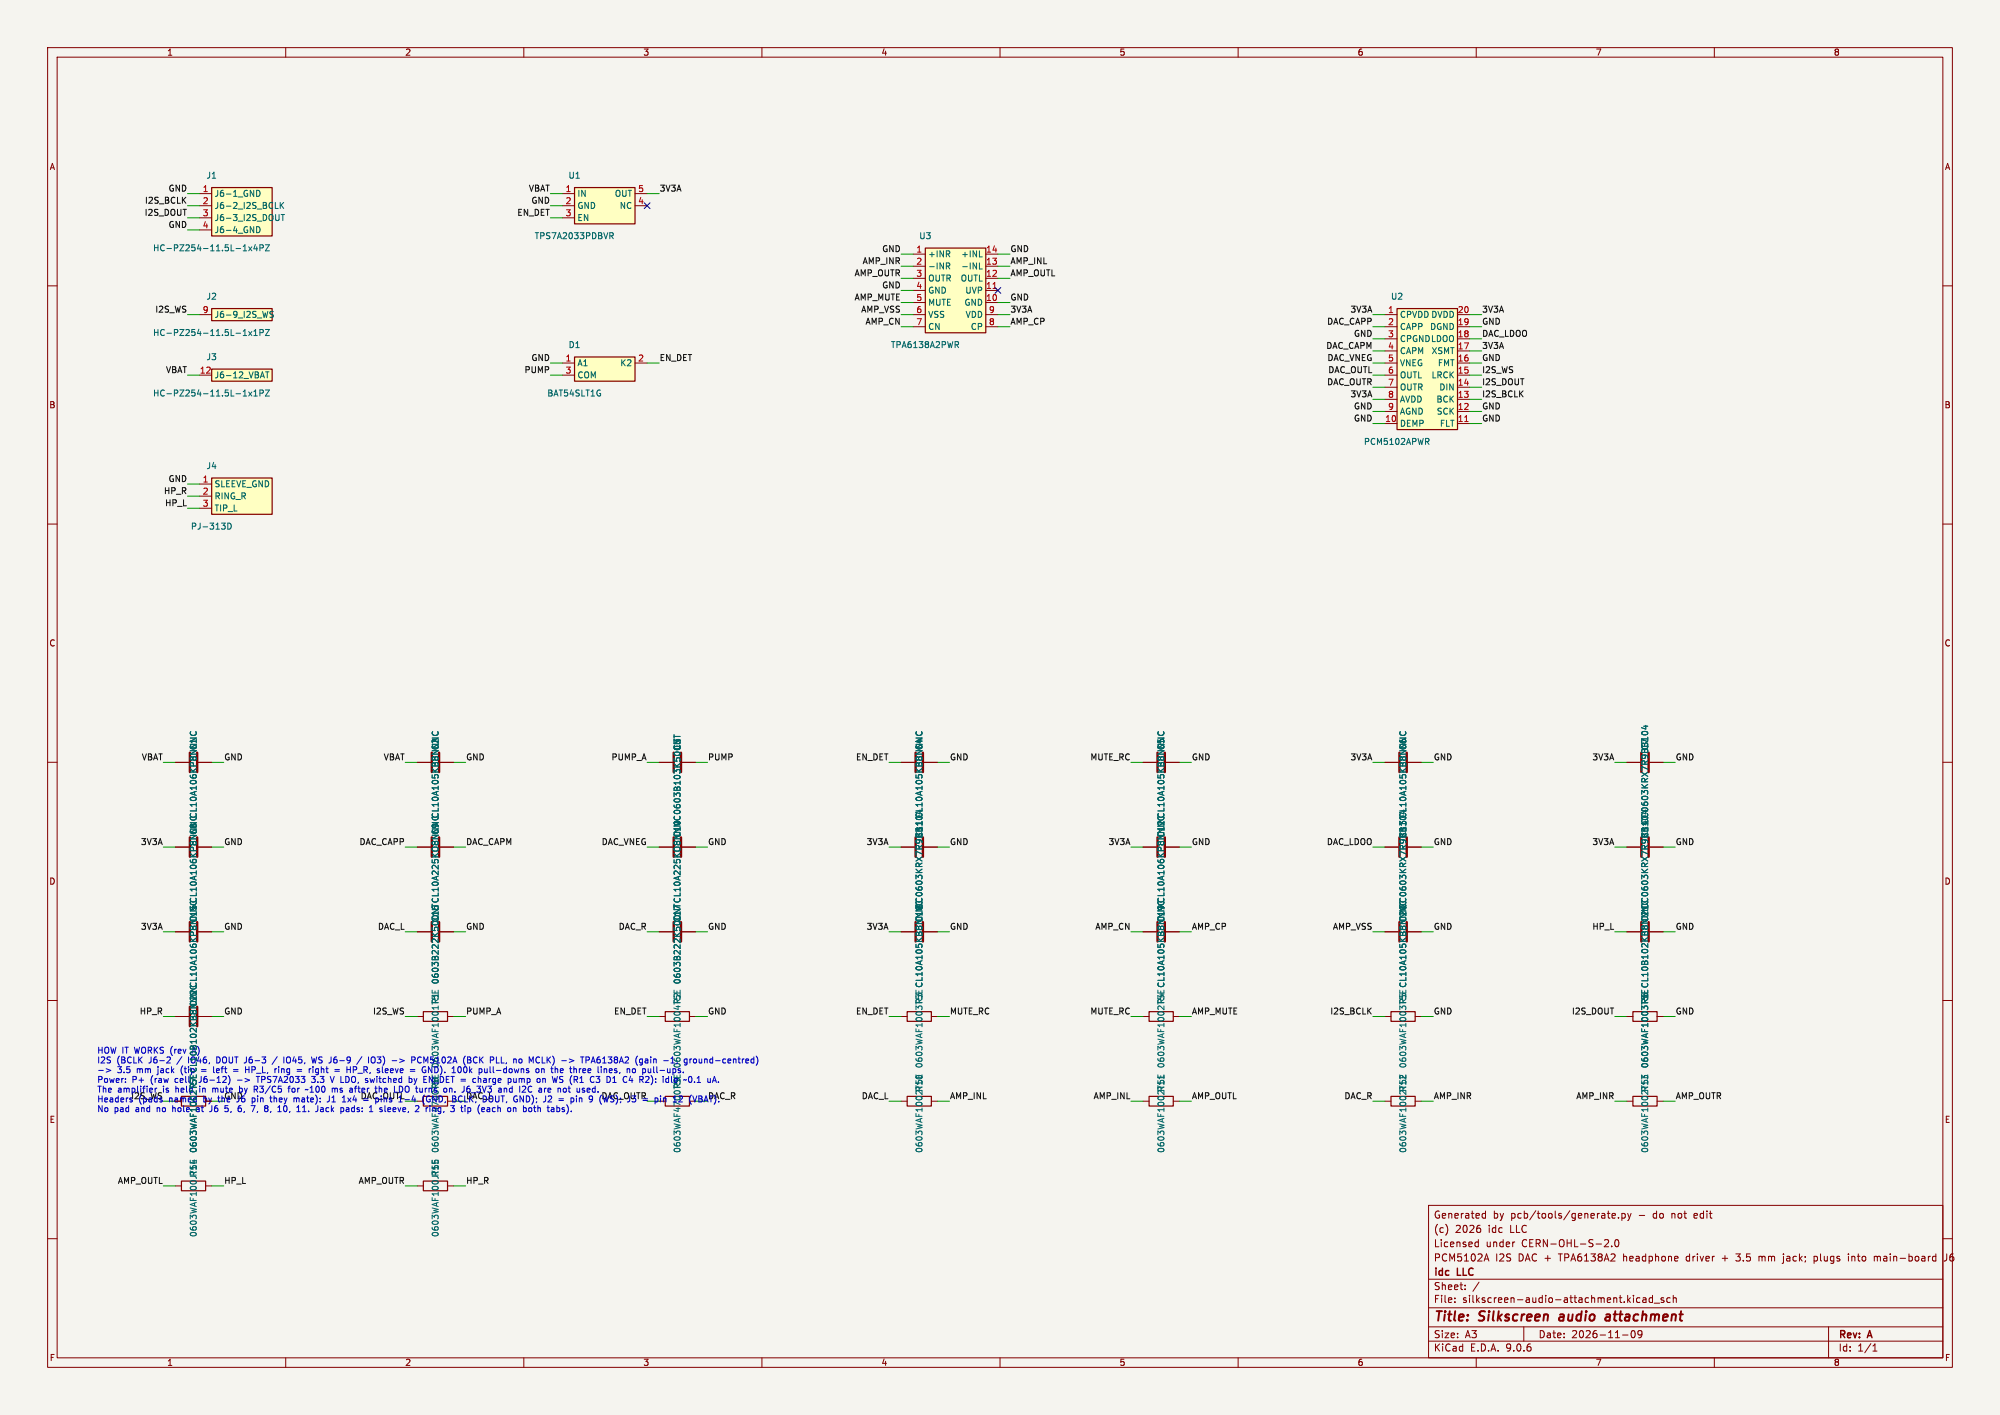
[picture p15: page 1]

HOW IT WORKS (rev A)

Id: 1/1 Title: Silkscreen audio attachment File: silkscreen-audio-attachment.kicad_sch Sheet: /
