iandchasse/silkscreen-audio-attachment/pcb/docs/silkscreen-audio-attachment_layout.pdf

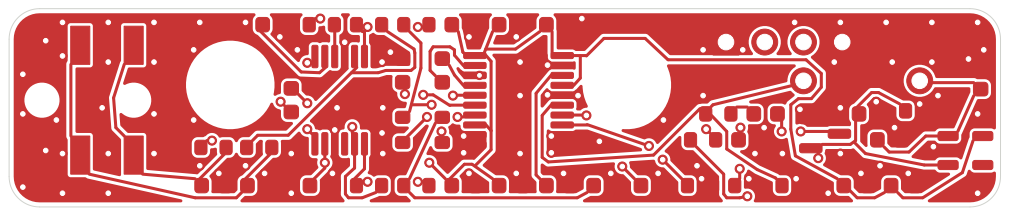
[picture p16: page 1]

Id: 1/6 Title: Silkscreen audio attachment File: silkscreen-audio-attachment.kicad_pcb Sheet:

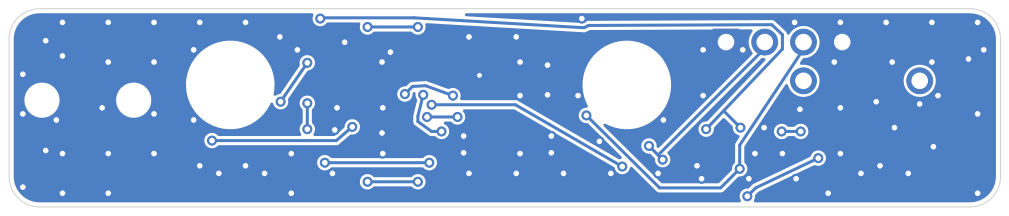
[picture p17: page 2]

Id: 2/6 Title: Silkscreen audio attachment File: silkscreen-audio-attachment.kicad_pcb Sheet:

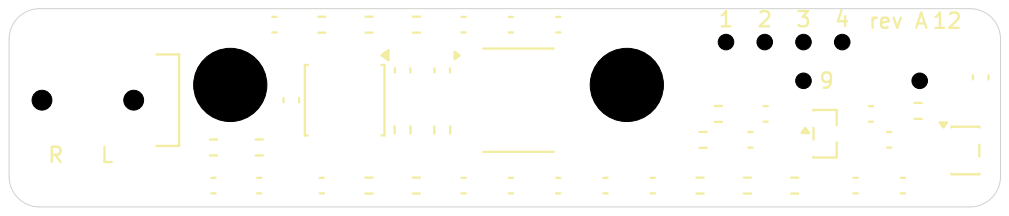
[picture p18: page 3]

Id: 3/6 Title: Silkscreen audio attachment File: silkscreen-audio-attachment.kicad_pcb Sheet:

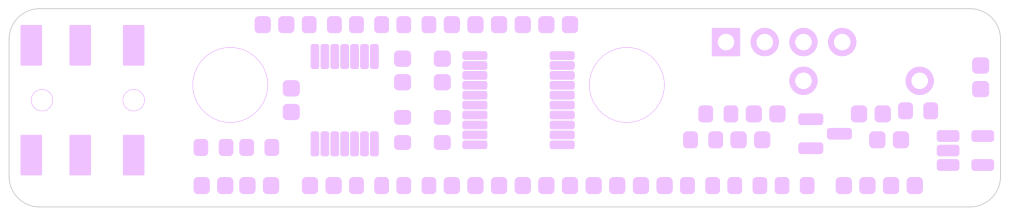
[picture p19: page 4]

Id: 4/6 Title: Silkscreen audio attachment File: silkscreen-audio-attachment.kicad_pcb Sheet:

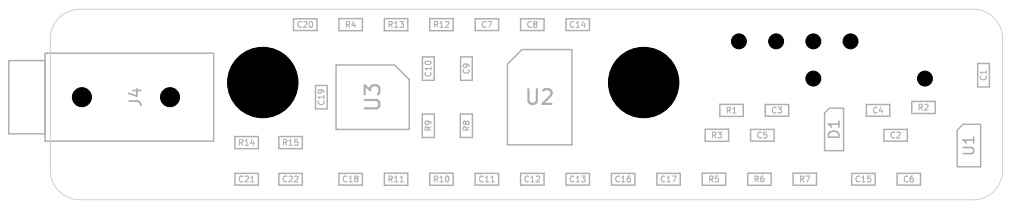
[picture p20: page 5]

Id: 5/6 Title: Silkscreen audio attachment File: silkscreen-audio-attachment.kicad_pcb Sheet:

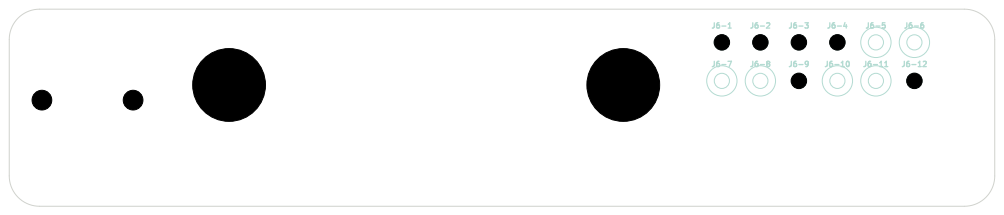
[picture p21: page 6]

Id: 6/6 Title: Silkscreen audio attachment File: silkscreen-audio-attachment.kicad_pcb Sheet:
