iandchasse/silkscreen-audio-attachment/pcb/silkscreen-audio-attachment.kicad_pcb

## KiCad design pcb/silkscreen-audio-attachment.kicad_pcb (2026-11-09)

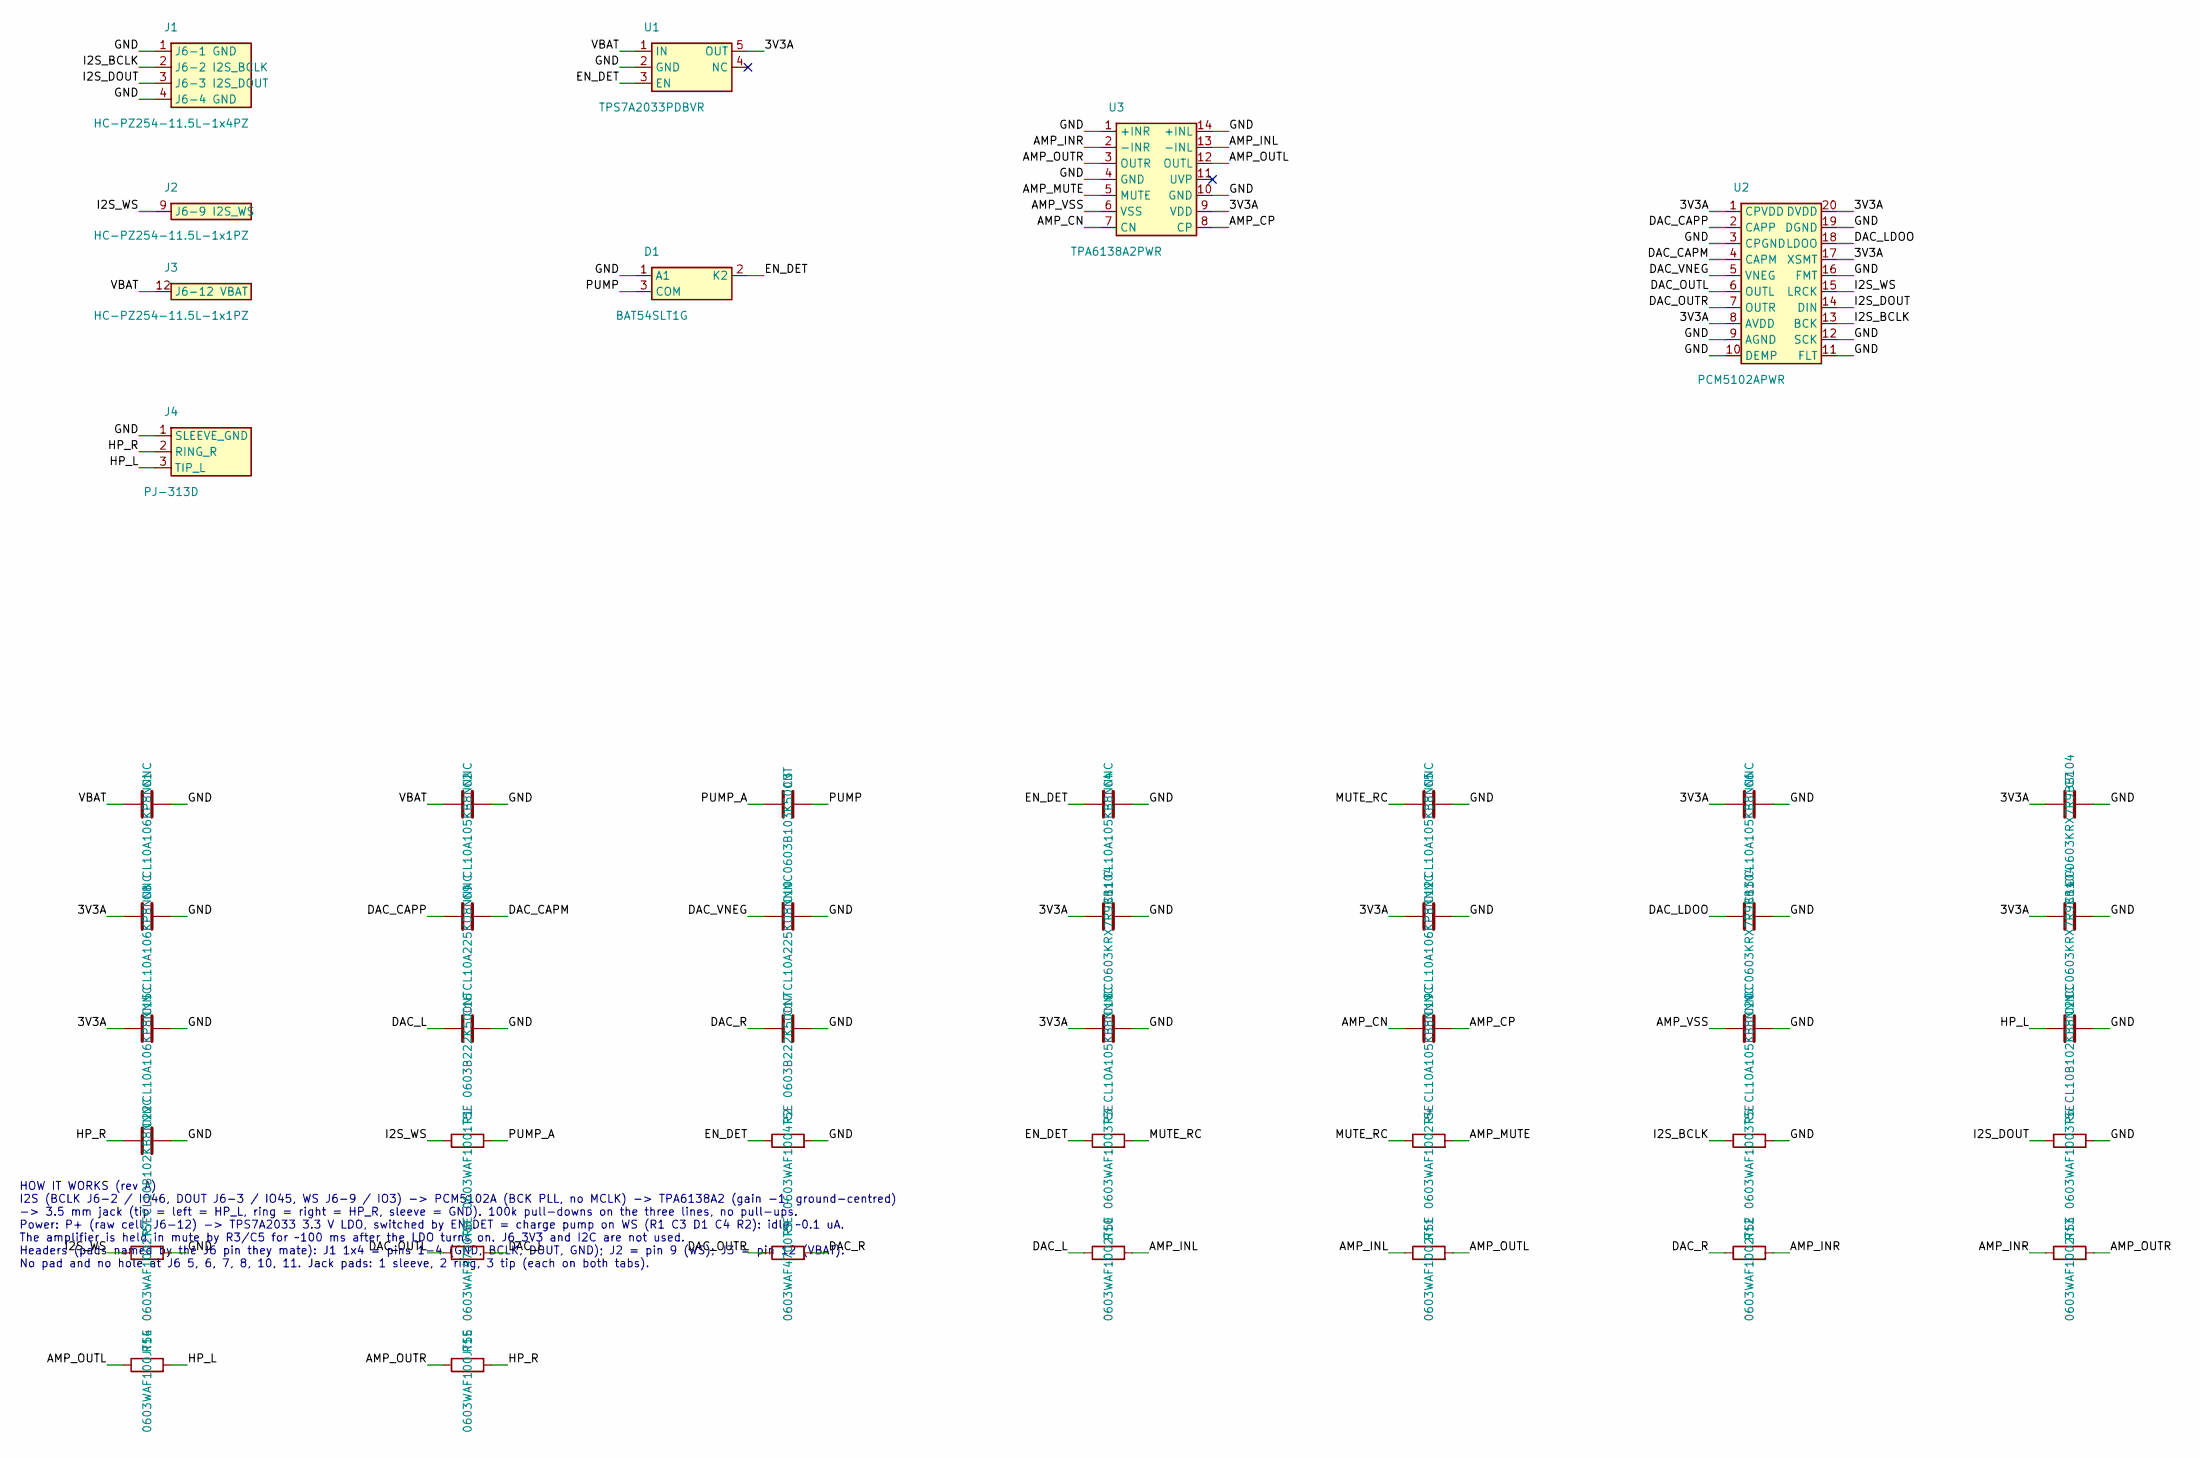
[picture p22: schematic silkscreen-audio-attachment.kicad_sch, Silkscreen audio attachment]

Parts:
C1, C8, C12, C15: CL10A106KP8NNNC; C_0603_1608Metric; MPN CL10A106KP8NNNC; DigiKey search DigiKey for CL10A106KP8NNNC (par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
C2, C4, C5, C6, C18, C19, C20: CL10A105KB8NNNC; C_0603_1608Metric; MPN CL10A105KB8NNNC; DigiKey search DigiKey for CL10A105KB8NNNC (par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
C3: 0603B103K500NT; C_0603_1608Metric; MPN 0603B103K500NT; DigiKey search DigiKey for 0603B103K500NT (part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
C7, C11, C13, C14: CC0603KRX7R9BB104; C_0603_1608Metric; MPN CC0603KRX7R9BB104; DigiKey search DigiKey for CC0603KRX7R9BB104 (p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
C9, C10: CL10A225KO8NNNC; C_0603_1608Metric; MPN CL10A225KO8NNNC; DigiKey search DigiKey for CL10A225KO8NNNC (par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
C16, C17: 0603B222K500NT; C_0603_1608Metric; MPN 0603B222K500NT; DigiKey search DigiKey for 0603B222K500NT (part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
C21, C22: CL10B102KB8NNNC; C_0603_1608Metric; MPN CL10B102KB8NNNC; DigiKey search DigiKey for CL10B102KB8NNNC (par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
D1: BAT54SLT1G; SOT-23; MPN BAT54SLT1G; DigiKey BAT54SLT1GOSCT-ND
J1: HC-PZ254-11.5L-1x4PZ; J6_PLUG_1x4_P1-P4; MPN HC-PZ254-11.5L-1x4PZ; DigiKey n/a - Hong Cheng is LCSC-only; DigiKey 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
J2: HC-PZ254-11.5L-1x1PZ; J6_PLUG_1x1_P9; MPN HC-PZ254-11.5L-1x1PZ; DigiKey 1 pin cut from a Harwin M20-999 series 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
J3: HC-PZ254-11.5L-1x1PZ; J6_PLUG_1x1_P12; MPN HC-PZ254-11.5L-1x1PZ; DigiKey 1 pin cut from a Harwin M20-999 series 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
J4: PJ-313D; JACK_3.5mm_SHOUHAN_PJ-313D; MPN PJ-313D; DigiKey none (LCSC only); DigiKey alternative w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
R1: 0603WAF1001T5E; R_0603_1608Metric; MPN 0603WAF1001T5E; DigiKey search DigiKey for 0603WAF1001T5E (part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
R2: 0603WAF1004T5E; R_0603_1608Metric; MPN 0603WAF1004T5E; DigiKey search DigiKey for 0603WAF1004T5E (part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
R3, R5, R6: 0603WAF1003T5E; R_0603_1608Metric; MPN 0603WAF1003T5E; DigiKey search DigiKey for 0603WAF1003T5E (part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
R4, R7, R10, R11, R12, R13: 0603WAF1002T5E; R_0603_1608Metric; MPN 0603WAF1002T5E; DigiKey search DigiKey for 0603WAF1002T5E (part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
R8, R9: 0603WAF4700T5E; R_0603_1608Metric; MPN 0603WAF4700T5E; DigiKey search DigiKey for 0603WAF4700T5E (part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
R14, R15: 0603WAF100JT5E; R_0603_1608Metric; MPN 0603WAF100JT5E; DigiKey search DigiKey for 0603WAF100JT5E (part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
U1: TPS7A2033PDBVR; SOT-23-5; MPN TPS7A2033PDBVR; DigiKey 296-TPS7A2033PDBVRCT-ND
U2: PCM5102APWR; TSSOP-20_4.4x6.5mm_P0.65mm; MPN PCM5102APWR; DigiKey 296-36707-1-ND
U3: TPA6138A2PWR; TSSOP-14_4.4x5mm_P0.65mm; MPN TPA6138A2PWR; DigiKey 296-28248-1-ND

Connections:
/3V3A: C6.1, C7.1, C8.1, C11.1, C12.1, C14.1, C15.1, C18.1, U1.5 (OUT), U2.1 (CPVDD), U2.8 (AVDD), U2.17 (XSMT), U2.20 (DVDD), U3.9 (VDD)
/AMP_CN: C19.1, U3.7 (CN)
/AMP_CP: C19.2, U3.8 (CP)
/AMP_INL: R10.2, R11.1, U3.13 (-INL)
/AMP_INR: R12.2, R13.1, U3.2 (-INR)
/AMP_MUTE: R4.2, U3.5 (MUTE)
/AMP_OUTL: R11.2, R14.1, U3.12 (OUTL)
/AMP_OUTR: R13.2, R15.1, U3.3 (OUTR)
/AMP_VSS: C20.1, U3.6 (VSS)
/DAC_CAPM: C9.2, U2.4 (CAPM)
/DAC_CAPP: C9.1, U2.2 (CAPP)
/DAC_L: C16.1, R8.2, R10.1
/DAC_LDOO: C13.1, U2.18 (LDOO)
/DAC_OUTL: R8.1, U2.6 (OUTL)
/DAC_OUTR: R9.1, U2.7 (OUTR)
/DAC_R: C17.1, R9.2, R12.1
/DAC_VNEG: C10.1, U2.5 (VNEG)
/EN_DET: C4.1, D1.2 (K2), R2.1, R3.1, U1.3 (EN)
/GND: C1.2, C2.2, C4.2, C5.2, C6.2, C7.2, C8.2, C10.2, C11.2, C12.2, C13.2, C14.2, C15.2, C16.2, C17.2, C18.2, C20.2, C21.2, C22.2, D1.1 (A1), J1.1 (J6-1 GND), J1.4 (J6-4 GND), J4.1 (SLEEVE_GND), R2.2, R5.2, R6.2, R7.2, U1.2 (GND), U2.3 (CPGND), U2.9 (AGND), U2.10 (DEMP), U2.11 (FLT), U2.12 (SCK), U2.16 (FMT), U2.19 (DGND), U3.1 (+INR), U3.4 (GND), U3.10 (GND), U3.14 (+INL)
/HP_L: C21.1, J4.3 (TIP_L), R14.2
/HP_R: C22.1, J4.2 (RING_R), R15.2
/I2S_BCLK: J1.2 (J6-2 I2S_BCLK), R5.1, U2.13 (BCK)
/I2S_DOUT: J1.3 (J6-3 I2S_DOUT), R6.1, U2.14 (DIN)
/I2S_WS: J2.9, R1.1, R7.1, U2.15 (LRCK)
/MUTE_RC: C5.1, R3.2, R4.1
/PUMP: C3.2, D1.3 (COM)
/PUMP_A: C3.1, R1.2
/VBAT: C1.1, C2.1, J3.12, U1.1 (IN)

Notes on the sheet:
HOW IT WORKS (rev A) I2S (BCLK J6-2 / IO46, DOUT J6-3 / IO45, WS J6-9 / IO3) -> PCM5102A (BCK PLL, no MCLK) -> TPA6138A2 (gain -1, ground-centred) -> 3.5 mm jack (tip = left = HP_L, ring = right = HP_R, sleeve = GND). 100k pull-downs on the three lines, no pull-ups. Power: P+ (raw cell, J6-12) -> T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

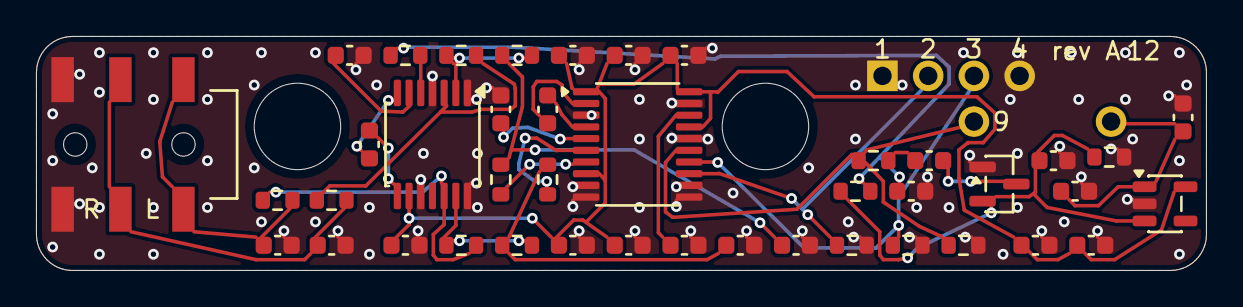
[picture p23: board silkscreen-audio-attachment.kicad_pcb from above]

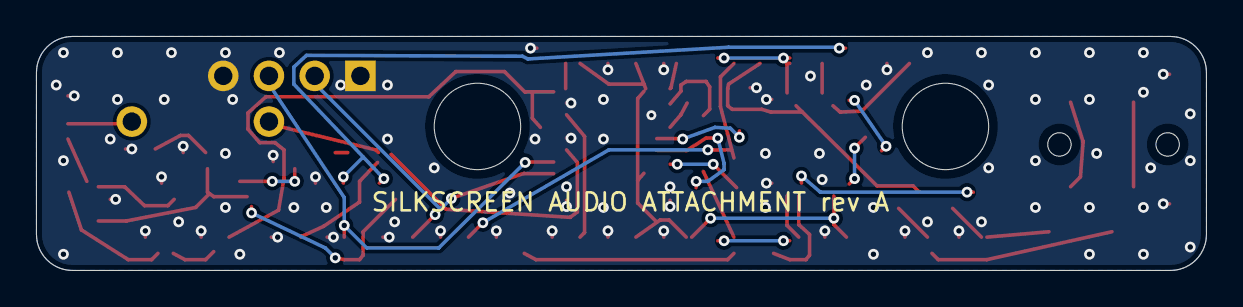
[picture p24: board silkscreen-audio-attachment.kicad_pcb from below]

Board: 2 copper layers, 65.0 x 13.0 mm, 47 parts (3 on the bottom side), 28 nets.

Other parts of the board:
H1: M1 lid screw column (rev C base, left boss moved 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; NPTH_4.80mm
H2: M2 lid screw column; NPTH_4.80mm
