iandchasse/silkscreen-audio-attachment/(notices)

Notices in the files:
pcb/silkscreen-audio-attachment.kicad_sch:
Licensed under CERN-OHL-S-2.0
(c) 2026 idc LLC
